SSC202/Three_Port_ACDC_Converter/Report/电赛报告.pdf

参赛队代码：

| 装 | 订 | 线 |

# 能量回馈的变流器负载试验装置

## 设计论文

摘要

本方案电路由基于 STM32H723ZGT6 的控制回路、基于 INN650TA030AH

的宽禁带器件功率回路及相关外围电路组成，实现了可以能量回馈的、具备电压

闭环、电流闭环和零序环流抑制功能的低功耗三相变流器负载试验装置。系统首

先通过线电压采样和坐标变换，并调节变流器 1 输出实现了电压闭环。随后，本

系统通过电流反馈，并利用变流器 2 输出对基波电流进行闭环控制，对零序环流

进行抑制。本系统可稳定输出线电压 32.0V、频率 50.0Hz 的三相交流电，实测总

谐波失真为 0.3%，远小于 2%的设计要求，负载调整率为 0.189%，同时具备±1.0Hz

步进的调频能力。本系统各项技术指标均达到赛题要求，实现了高效能量回馈，

具有控制精度高、谐波少、稳定性高的特点。

关键词： 坐标变化；闭环控制；零序环流抑制；能量回馈

目 录

## 一、总体方案设计

### 1. 电路总体设计

系统总体设计框图如图 1-1 所示：

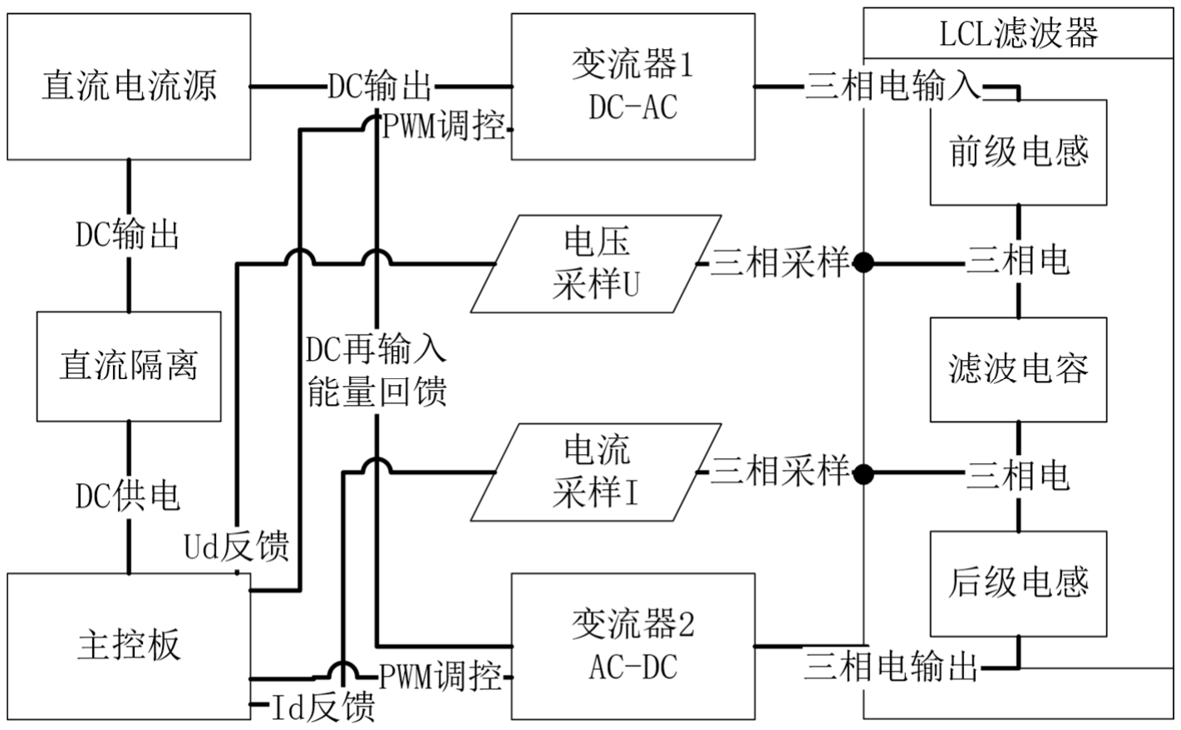
[picture p6: figure]

图 1-1 系统总体设计框图

电路整体分为软件主控与硬件受控部分组成。软件主控基于 STM32H723ZGT6 作为核心板。硬件受控部分则是由 INN650TA030AH 晶体管所

构成的半桥与电压/电流采样板所组成。

软件主控实现 SPWM 控制。PI 调节功能。半桥实现 SPWM，提供其所需的

电压向量以合成所需电压。电压，流采样板对应进行采样，实现反馈数据的收集。

软件通过 SPWM 作用于半桥，电压，电流采样通过 ADC 将数据输入至主控

板之中

### 2. 技术方案比较

（1）软控模块-信号坐标系设立

方案一：ABC 三项建立自然坐标系。在这种情况下，直接以 ABC 三项进行

合成分解。该坐标系建立简单。但在这种坐标系下，ABC 三项会随时间变化，呈

z 正弦波形式，计算量大。不利于参数调试。
方案二：clarck 变换，clarck 变换后将自然 ABC 三项坐标系转换为αβ, 两轴

坐标，减少了控制器数目，但该情况下。αβ, 两坐标轴仍保持静止。所监测的电

压在αβ, 上的分量仍保持为正弦波形式，随时间变化，不利于参数调试。

方案三：clarck-park 变换。在 clarck 变换的基础之上，我们将得到的αβ, 两

坐标轴进行更进一步的变换，令我们得到的αβ, 两坐标轴以与所检测的电压相同

的角速度进行旋转得到动态的dq, 坐标轴，这种情况之下。我们所检测的电压与

dq, 坐标轴保持相对静止。其在dq, 坐标轴上的投影量为直流量，不随时间变化。

因此问题转换为在一旋转坐标系下直流信号跟踪问题

综上可知，方案一与方案二涉及到交流信号跟踪问题，交流信号跟踪所使用

的 PR 算法复杂且难以调控，因此采用方案三，将问题转换为直流信号跟踪问题，

可以使用 PI 算法，使得调节相对简单且常用。综合考虑后选择方案三。

（2）软控模块-跟踪算法选择

方案一：比例-积分(PI)控制，PI 控制包括比例项(P)和积分项(I)，比例项反应

当前误差，积分项反应历史误差。通过动态修正使得输出稳定值预定值。其具有

操作简单且速率较快的优点。但与此同时，当我们使用 PI 控制器跟踪正弦信号

时，由于 PI 算法的基本原理，会导致产生无法消除的正弦稳态误差。影响跟踪

效果。

方案二：比例谐振(PR)控制。PR 控制的特性为，在所设定的频率处增益非常

大。其他频段的增益为固定增益。因此相对于 PI 控制，PR 可以很好的处理交流

信号。并且不会有无法消除的正弦稳态误差影响。但其调节参数相对 PI 控制多，

且调节难度高。

综上所述，鉴于我们已使用 clarck-park 变换，将问题转化为直流信号跟踪问

题，在这个前提之下，PI 控制更适用于我们的需求，PR 控制调节难度相对较高。

综合考虑后采用方案一。

（3）综合模块-电压合成算法选择

方案一：SPWM：以输入一端幅值等效的方波从而来等效正弦波，这里使用

自然采样法，即使用三角波与正弦波进行对比。根据三角波当前时刻超过/低于正

弦波从而改变方波高\低电平。从而进行模拟，其操作相对简单，但是其峰值不可

超过供电峰值1/2，易发生超调现象。

方案二：SVPWM：空间矢量脉宽调制算法，借助半桥结构，通过三组板桥

的开关 从而形成 3 2 个不同方向的电压向量。再通过不同的电流向量不同时间的

搭配，从而以多个向量构成我们所需要的电压向量。其操作相对复杂且会引入零

序分量(三次谐波)，但其相对于 SPWM 需要更小的电压峰值 3/3利用率提高了 15.47%。

综上所述， 因为 SVPWM 会引入零序分量导致环流，效率降低，且在本设

计当中，所拥有的直流电源电压范围大。可满足我们的实际需求(60.0V)合理选择

电压后。可避免发生超调，则采用 SPWM 方式进行模拟。

## 二、理论分析与计算

### 1. 能量回馈原理

电流通过连接单元后，通过变流器 2(AC-DC)将原本的交流电整流升压，并

将产生的直流电源端输入的 DC 电压幅值，再重新传输至变流器 1(DC-AC)的输

入极。通过这种方式实现“变流器 1-连接单元-变流器 2-变流器 1”的能量回馈。

在具体的变流器 2：AC-DC 当中。逆向使用变流器 1：DC-AC 的方式，从而

实现 AC-DC 且前后电压变化近似一致。减少能量在回馈过程中的劣化。

### 2. LCL 电路参数

在逆变器 LCL 滤波电路之中，参考标准 LCL 滤波电路构型，相关参数如表 2-1

表 2-1 LCL 滤波电路相关参数

Vin 输入电压 | Tsw 载波周期 | λ L1 纹波系数 | LI 额定电流 | Po 单相有功功率 | U g 输出电压
32.0 | 5 5*10 s ⁻ | 0.1 | 2.0A | 64.0W | 32.0V

且要求谐振频率频率约为 1.0KHZ 可、避开由 SPWM 所产生的 3，5 倍谐波

干扰，且在电流环控制范围内。

1) 高频电感 L1 :

1
1 | 1
i | 2.0mH
4 , in | c | in sw
in | on | min LL
L V V | VT T
L | I λ
− 其需满足 | 代入公式 L Δ | ≈ = | =
2) 低频电感 L2 :
1 | 2 | 1
2 | 2 | 2
12 | 1
9 , | , | 2.0mH 4* | 9 r

sw

LL | L LC | L
LLC | f LC

ω
π
+ | = − 由谐振角频率 | = | = 考虑 | 并联影响后

滤波电容C :一般滤波电容所引入的无功功率为理论上单项额定有功的

5.0%。但在实际实践当中为了稳定取 10.0%-20.0%。代入公式求得

2 *12.5% 25.0uf
*

o
max
g
C | P
ω U = | =

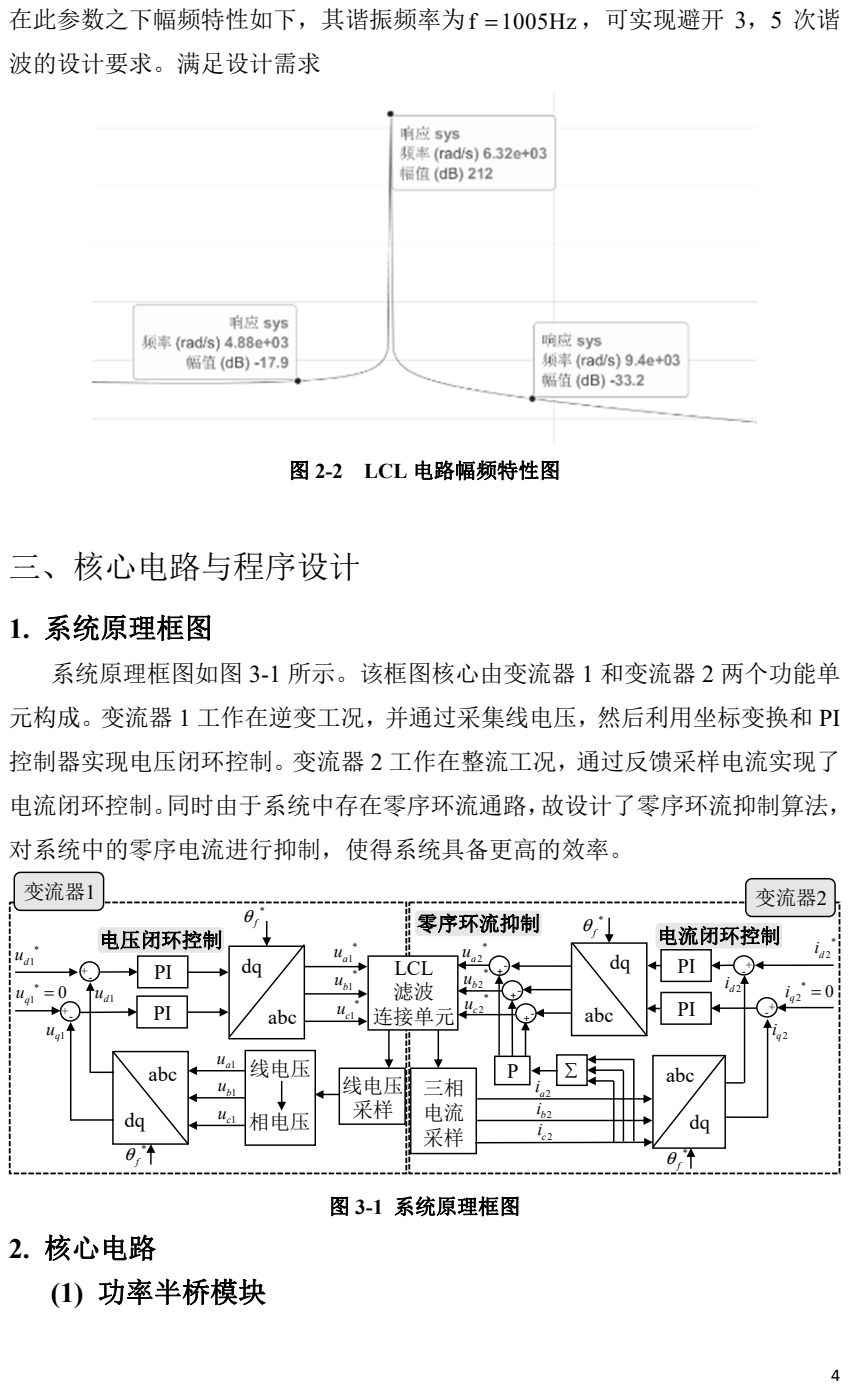
[picture p7: page 7]
在此参数之下幅频特性如下，其谐振频率为f 1005Hz =; ，可实现避开 3，5 次谐; 波的设计要求。满足设计需求; 图 2-2 LCL 电路幅频特性图; 三、核心电路与程序设计; 1. 系统原理框图; 图 3-1 系统原理框图; 2. 核心电路; (1) 功率半桥模块; abc; 线电压; 相电压; 线电压 采样; LCL 滤波 连接单元; 变流器; 变流器2 1; 电压闭环控制; 电流闭环控制 零序环流抑制

系统原理框图如图 3-1 所示。该框图核心由变流器 1 和变流器 2 两个功能单
元构成。变流器 1 工作在逆变工况，并通过采集线电压，然后利用坐标变换和 PI
控制器实现电压闭环控制。变流器 2 工作在整流工况，通过反馈采样电流实现了
电流闭环控制。同时由于系统中存在零序环流通路，故设计了零序环流抑制算法，
对系统中的零序电流进行抑制，使得系统具备更高的效率。

功率半桥模块由滤波前端，驱动电路，GaN 半桥所组成。驱动电路使用

UCC21220ADR 驱动芯片增强驱动能力以精准控制 GaN 开关管。半桥结构采用 INN650TA030AH 功率晶体管.以实现响应 PWM,实现半桥开关。

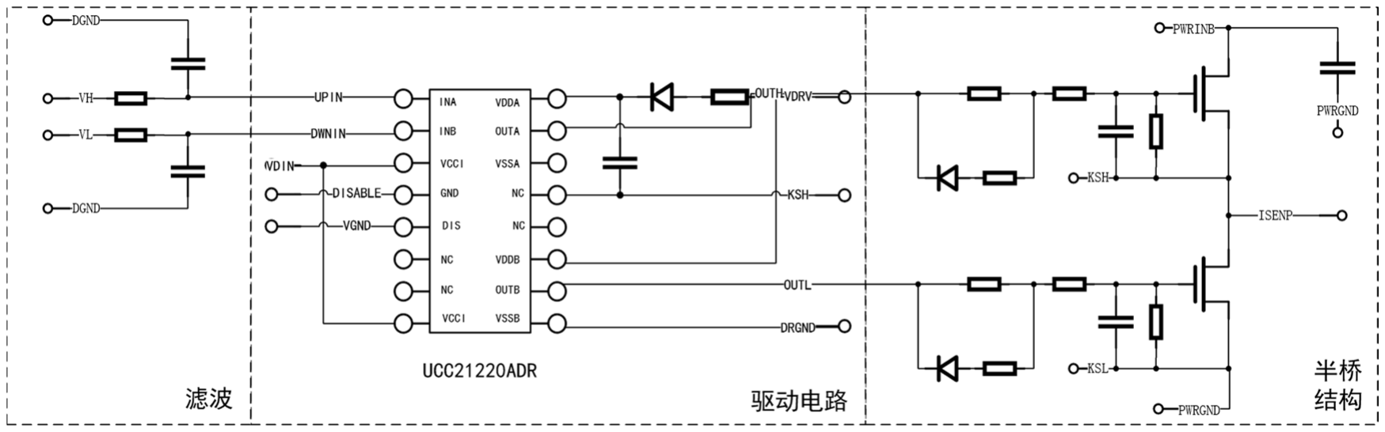
[picture p8: figure]

图 3-2 功率半桥及其驱动模块电路

### 2. 电压采样模块

电压采样模块前端使用 AMC1311BDWVR 隔离放大器实现电气隔离放大并

在后侧采用运放放大器实现放大，从而实现精准线性采集电路电压效果。

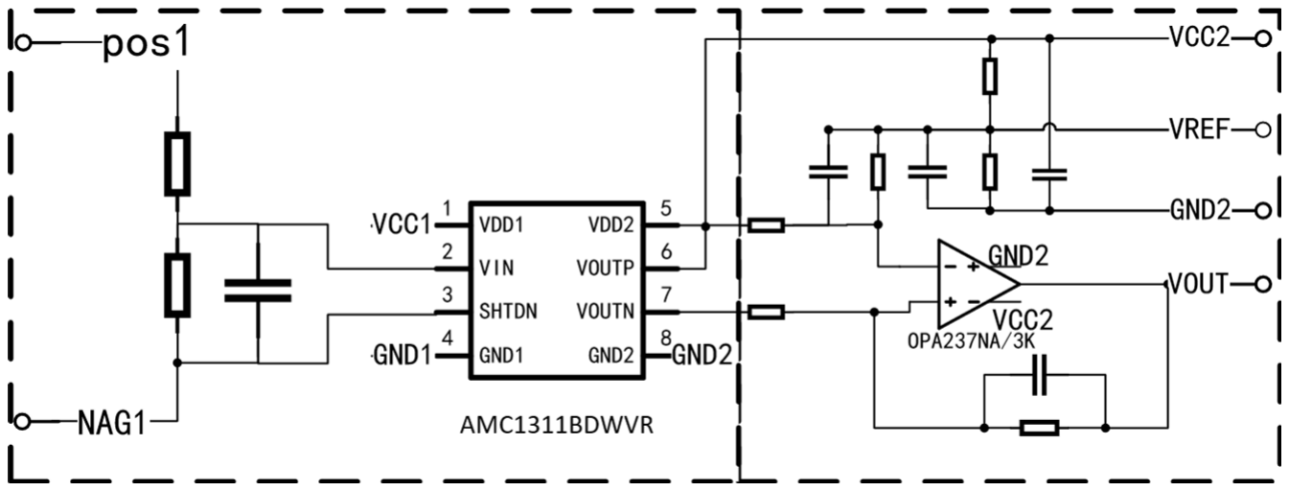
[picture p9: figure]

图 3-3 电压采样模块电路

### 3. 电流采样模块

利用 TMCS1107A3BQDR 隔离霍尔电流传感器进行电流采样，实现工作范

围内精确线性采样。

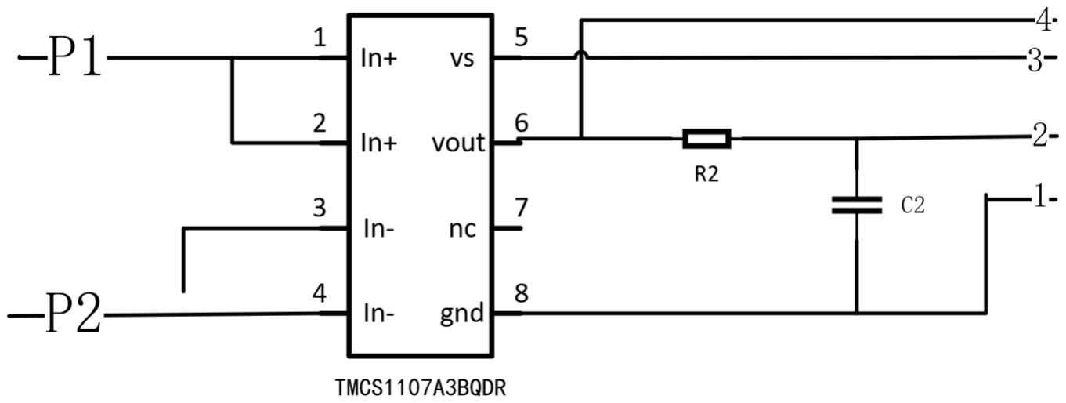
[picture p10: figure]

图 3-4 电路采样模块电路

### 4. 程序设计

### (1) 三相 SPWM 脉冲调制:

SPWM 即为将一标准三角波与调制正弦波进行对比.当三角波低于正弦波时

输出高电平，当三角波高于正弦波时输出低电平，以此通过电压均值来模拟我们

所需要的正弦电压.在实际交互环节当中通过生成的 PWM 注入半桥,板桥内部的

驱动器接受 PWM 从而调节 GaN 开关管的开关，进而实现高电压幅度下的电压

调制，从而在电路中实现 AC-DC 与 DC-AC 的变流器作用。通过三相的互差 120

度的 SPWM 调制即可产生三相 SPWM 的脉冲调制，进而实现三相 AC-DC 与 DC-AC 的变流。

### (2) 坐标变化:

通过 clark-park 变换，将 ABC 三相静止的坐标系下的交流分量转为 dq 坐标

系下的直流分量。因静止坐标系获取电压会得到变化的交流值，如果坐标系实现

同角速度动态变化，则得到的电压值为静态的直流值，直流分量的幅值可以直接

反映交流分量的幅值，也可用通过 PI 控制器对直流分量进行控制。

(3) 基波控制与零序环流抑制:

基波控制采用双变流器协同策略：变流器 1 通过电压闭环控制实现直流母线

稳压，其 d 轴电压环采用 PI 调节器跟踪指令电压，q 轴电压置零以实现单位功

率因数运行；变流器 2 则通过电流闭环控制精确跟踪指令电流，采用电流环 PI

调节器结合 P 控制器实现快速动态响应。由于该电路存在零序环流通路，故两变

流器通过中央零序环流抑制模块动态耦合，该模块实时检测并联支路的零序电流

分量，通过闭环补偿算法生成反相抑制信号，有效消除因参数不对称或开关动作

引起的环流扰动。

(4) 程序软件流程图:

程序流程框图如图 3-5 所示，程序启动后，首先通过按键选择题目确定运行

模式，随后执行 ADC 校正确保采样精度。系统核心采用中断响应机制：由启动

/停止按键和过流保护触发中断。过流时强制打开三相桥下桥臂紧急停机；正常启

动后则进入运行状态。在启动运行阶段，流程分为并行两路：基础部分：进行电

压电流采样。扩展部分：实现能量反馈。

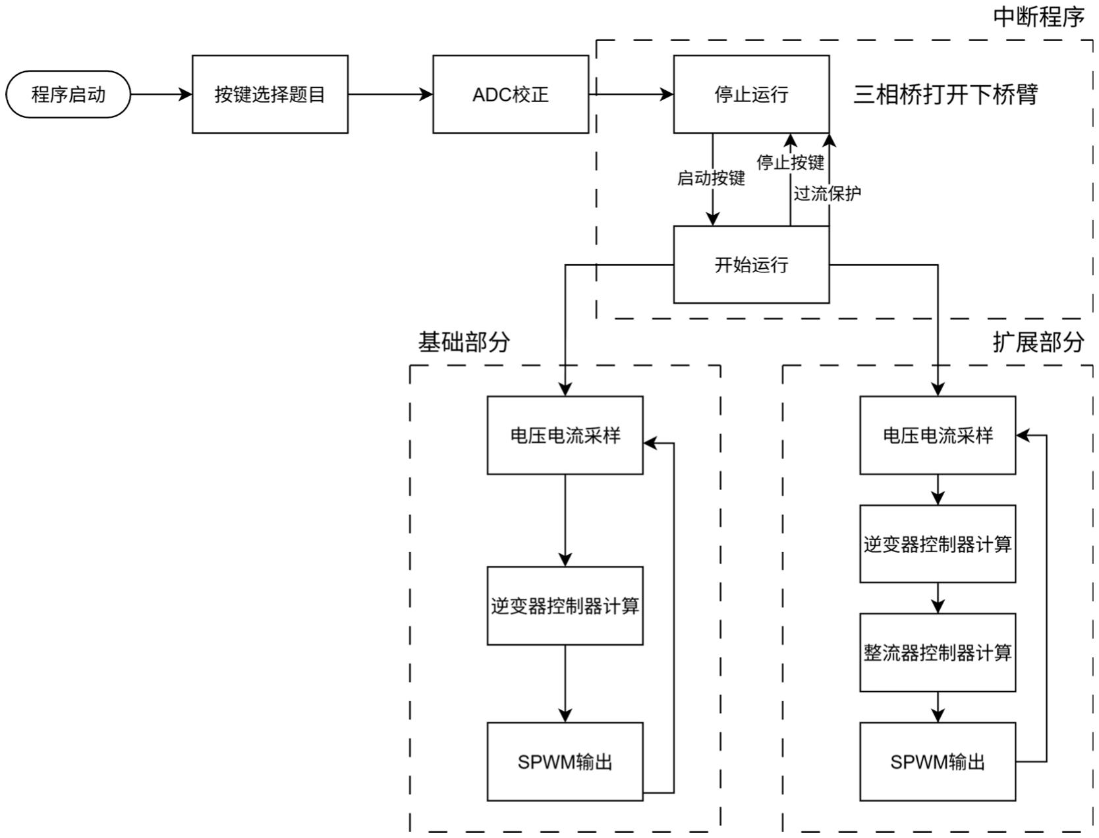
[picture p11: figure]

图 3-5 程序软件流程图

## 四、测试结果与分析

### 1. 基础要求的测试

表 5-1 测试条件
供电电源 | RIGOL 普源 DP832A 直流电源
测量设备 | tektronix MDO3024 示波器、fluke 434 series Ⅱ质量分析仪
供电条件 | 直流供电 55.0V
(1)输出特性测试:

基础要求(1)测试如表 5-2, U =± 32 0.5V , I = 2A , f = 50Hz满足题目要求。

表 5-2 基础要求（1）测试数据

线电压 | 线电压 U/V | 线电流 I/A | 频率 f Hz
U1 | 32.09 | 2.032 | 50.0
U2 | 32.11 | 1.968 | 50.0
U3 | 32.12 | 1.885 | 50.0

### (2) 总谐波失真(THD)测试:

基础要求(2)测试如表 5-3，总 THD 为 0.3%，小于要求 2.0%满足题目要求

表 5-3 基础要求（2）测试数据
| 总 THD
谐波含量 | 0.3%
(3) 负载调整率测试：

基础要求(3)测试如表 5-4，负载调整率为 0.189%，满足题目要求

表 5-4 基础要求（3）测试数据
电流 1I /A | 线电压U1 /V | 负载调整率 11 S %
0.0 | 32.22 | 0.189%
2.0 | 32.16
(4) 调频功能测试：

系统输出频率可在 20-100Hz 范围内 1Hz 步进变化，满足题目要求。

### 2. 发挥部分的测试

(1) 能量回馈测试：

能量回馈的数据如表 5-5 所示。在实现能量回馈的情况下，直流电源供电功 率约 12.155W。

表 5-5 能量回馈测试数据

线电压 U1 | 线电流 1I | 频率 f | 直流电源电压 Ud | 直流电源电流 d I | 直流电源功率 Pd
31.97V | 2.04A | 50.0Hz | 55.0V | 0.221A | 12.155W
(2) 附加功能：

本作品在基本要求，发挥部分的基础上，元器件采型使用 GaN 晶体管，在整

体上实现了低功耗，低散热等功效。降低了能量消耗。

### 3. 成效总体对比

本文设计了一个具有能量反馈的变流器负载电路，在直流电源为 56.0V 条件
下，使得电路在实现输出频率 50 Hz ，线电压 1 U = | ± 32V 0. 5V 2 | ，额定线电流

1I = 2A 的三相对称正弦交流电 THD 为 0.3%，负载调整率 11 S = 0.189%并可以实

现20Hz ~ 100Hz范围内一 1.0Hz 为步进调频。同时实现了能量回馈，能量回馈过
程当中，变流器1输出频率50.0Hz，线电压 1 U = | ± 32V 0. 5V 2 | ，额定线电流 1I = 2A ，

直流电源输出功率 Pd =12.155W。
