SSC202/Three_Port_ACDC_Converter/(list of files, drawings)

Other design files:
Hardware/主控板.eprj
Hardware/半桥+驱动器.eprj
Hardware/电压采样.eprj
Hardware/电压采样隔离前级.eprj
Hardware/电流采样.eprj
