SSC202/Three_Port_ACDC_Converter/Software/Three_Port_ACDC_Converter.ioc

Mcu.UserName=STM32H723ZGTx
PA10.Signal=USART1_RX
PA13(JTMS/SWDIO).Signal=DEBUG_JTMS-SWDIO
PA14(JTCK/SWCLK).Signal=DEBUG_JTCK-SWCLK
PA5.Signal=TIM8_CH1N
PA6.Signal=ADCx_INP3
PA7.Signal=TIM1_CH1N
PA9.Signal=USART1_TX
PB0.Signal=ADCx_INP9
PB1.Signal=ADCx_INP5
PB10.Signal=GPXTI10
PB13.Signal=GPIO_Output
PB14.Signal=TIM8_CH2N
PB15.Signal=TIM8_CH3N
PB2.GPIO_Label=SWITCH1
PB2.Signal=GPXTI2
PB7.Signal=GPXTI7
PB8.Signal=GPXTI8
PB9.Signal=GPXTI9
PC0.Signal=ADCx_INP10
PC4.Signal=ADCx_INP4
PC6.Signal=S_TIM8_CH1
PC7.Signal=S_TIM8_CH2
PC8.Signal=S_TIM8_CH3
PD4.Signal=GPXTI4
PE10.Signal=TIM1_CH2N
PE11.Signal=S_TIM1_CH2
PE12.Signal=TIM1_CH3N
PE13.Signal=S_TIM1_CH3
PE9.Signal=S_TIM1_CH1
PF0.Signal=GPIO_Output
PF11.Signal=ADC1_INP2
PF12.Signal=ADC1_INP6
PF13.Signal=GPXTI13
PG7.Signal=GPIO_Output
PH0-OSC_IN.Signal=RCC_OSC_IN
PH1-OSC_OUT.Signal=RCC_OSC_OUT
