SSC202/Three_Port_ACDC_Converter/Software/User/usermain.h

#ifndef __USERMAIN_H
#define __USERMAIN_H

#include "stm32h7xx.h"
#include "stdio.h"

#include "tim.h"
#include "adc.h"
#include "usart.h"

#include "my_math.h"
#include "coordinate_transform.h"
#include "svpwm.h"

void usermain(void);

#endif
