SSC202/Three_Port_ACDC_Converter/(commit log)

2025-08-01 [Update]基础部分完成
2025-08-01 [Finish]发挥部分完成
2025-08-02 [Finish] 最终版本代码
2025-08-22 [Update] 资料整合
    [主控板.eprj, 半桥+驱动器.eprj, 电压采样.eprj, 电流采样.eprj]
