SSC202/Three_Port_ACDC_Converter/assets/picture_1.jpg

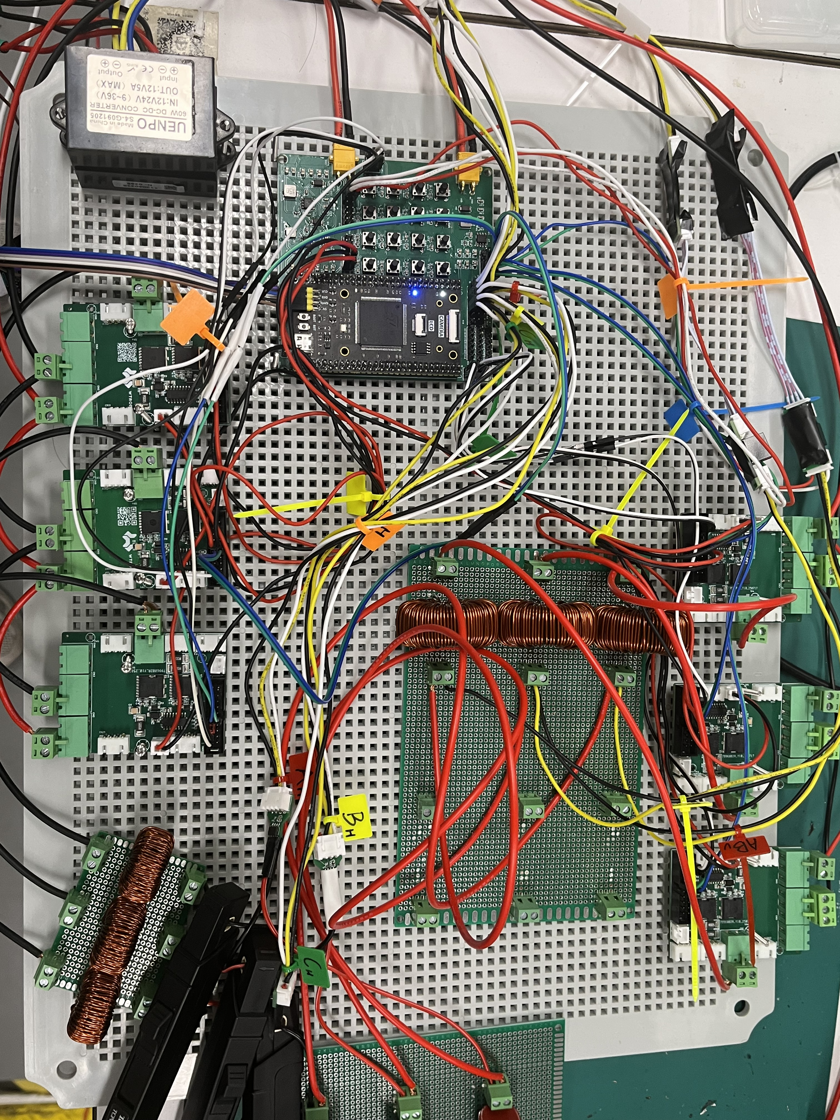
[picture p3: assets/picture_1.jpg]
assets/picture_1.jpg
